mizutanilab/radiation-counter/hostapp/ReadMe.txt

========================================================================
       MICROSOFT FOUNDATION CLASS ライブラリ : RadCountUsbHost
========================================================================

AppWizard が生成した RadCountUsbHost には、Microsoft Foundation Class の基本的な
使い方が示されています。アプリケーション作成のひな型としてお使いください。

このファイルには RadCountUsbHost を構成している各ファイルの概要説明が含まれています。

RadCountUsbHost.dsp
    このファイル (プロジェクト ファイル) はプロジェクト レベルの情報を含み、
    シングル プロジェクトまたはサブ プロジェクトのビルドに使用されます。他の
    ユーザーとプロジェクト ファイル (.dsp) を共有できますが、メイク ファイル
    はローカルにエクスポートしてください。

RadCountUsbHost.h
    このファイルはアプリケーションの中心となるインクルードファイルです。この
    ファイルは他のプロジェクトの固有のインクルードファイル（Resource.h  も含
    みます） をインクルードし、また CRadCountUsbHostApp アプリケーションクラスを宣
    言します。

RadCountUsbHost.cpp
    このファイルは CRadCountUsbHostApp アプリケーションクラスを含むアプリケーション
    の中心となるソースファイルです。

RadCountUsbHost.rc
    このファイルはプログラムが使用する Microsoft Windows のリソースを列挙しま
    す。このファイルは RES サブディレクトリに保存されているアイコン、ビットマ
    ップ、カーソルを含みます。このファイルは Microsoft Visual C++ で直接
    編集可能です。

RadCountUsbHost.clw
    このファイルは ClassWizard  が既存のクラスの編集やクラスを新規作成すると
    きに使う情報を持っています。またこのファイルは、ClassWizard によるメッセ
    ージ マップやダイアログ データ マップの編集や生成、プロトタイプ メンバ関
    数の生成に必要な情報も持っています。

res\RadCountUsbHost.ico
    このファイルは、アプリケーションのアイコンとして使用されるアイコンファイ
    ルです。このアイコンはリソース ファイル RadCountUsbHost.rc によってインクルード
    されます。

res\RadCountUsbHost.rc2
    このファイルは Microsoft Visual C++ によって編集されないリソースを含んでいま
    す。このファイルにリソース エディタで編集されないすべてのリソースを記述
    してください。

/////////////////////////////////////////////////////////////////////////////

AppWizard は 1 つのダイアログ クラスを作成します:

RadCountUsbHostDlg.h, RadCountUsbHostDlg.cpp - ダイアログ
    これらのファイルは CRadCountUsbHostDlg クラスを含みます。このクラスは 
    アプリケーションのメイン ダイアログの動作を定義します。ダイアログ
    テンプレートは Microsoft Visual C++ で編集可能な RadCountUsbHost.rc に含
    まれます。

/////////////////////////////////////////////////////////////////////////////
その他の標準ファイル:

StdAfx.h, StdAfx.cpp
    これらのファイルはプリコンパイル済ヘッダー ファイル (PCH) RadCountUsbHost.pch 
    やプリコンパイル済型ファイル StdAfx.obj を構築するために使われるファイルです。

Resource.h
    このファイルは新規リソース ID を定義する標準ヘッダー ファイルです。
    Microsoft Visual C++ はこのファイルを読み込み更新します。

/////////////////////////////////////////////////////////////////////////////
その他の注意:

"TODO:" で始まるコメントは、ソースコードの追加やカスタマイズの必要な場所を示
します。

アプリケーションで共有 DLL 内で MFC を使用する場合や、アプリケーションが
オペレーティング システムで現在使用している言語以外の言語を使用している場合は、
Microsoft Visual C++ CD-ROM から、ローカライズされたリソースに対応する
MFC42XXX.DLL を system または system32 ディレクトリにコピーして、ファイル名を 
MFC42LOC.DLL にする必要があります。("XXX" は言語の省略形を現します。例えば、
MFC42JPN.DLL は日本語に翻訳されたリソースを含みます。)
このようにしなかった場合には、アプリケーション内のいくつかの UI 要素はオペ
レーティング システムの言語のまま残ります。

/////////////////////////////////////////////////////////////////////////////
